berlin6699/2023-C/README.md

# 2023电赛C题
* 项目简介在项目介绍里
* 本项目仅为基础部分，即基础满分，但没有完成提高
