berlin6699/2023-C/软件/分立实现/ADC_TIM_2023C/ADC_TIM_2023C.ioc

Mcu.UserName=STM32F407ZGTx
PA10.Signal=USART1_RX
PA13.Signal=SYS_JTMS-SWDIO
PA14.Signal=SYS_JTCK-SWCLK
PA4.Signal=COMP_DAC1_group
PA6.Signal=ADCx_IN6
PA7.Signal=ADCx_IN7
PA9.Signal=USART1_TX
PB8.GPIO_Label=KEY1
PB8.Signal=GPXTI8
PB9.GPIO_Label=KEY0
PB9.Signal=GPXTI9
PF10.GPIO_Label=LED1
PF10.Signal=GPIO_Output
PF9.GPIO_Label=LED0
PF9.Signal=GPIO_Output
PH0-OSC_IN.Signal=RCC_OSC_IN
PH1-OSC_OUT.Signal=RCC_OSC_OUT
